marcinmrz/fcase-opatest/README.txt

To jest prototyp "alfa" testera zaczernienia osłonki kolagenowej.
"Alfa" oznacza, że działa albo i nie ;-)
