marcinmrz/fcase-opatest/3D_parts/głowica_vDB9_złożenie.stl

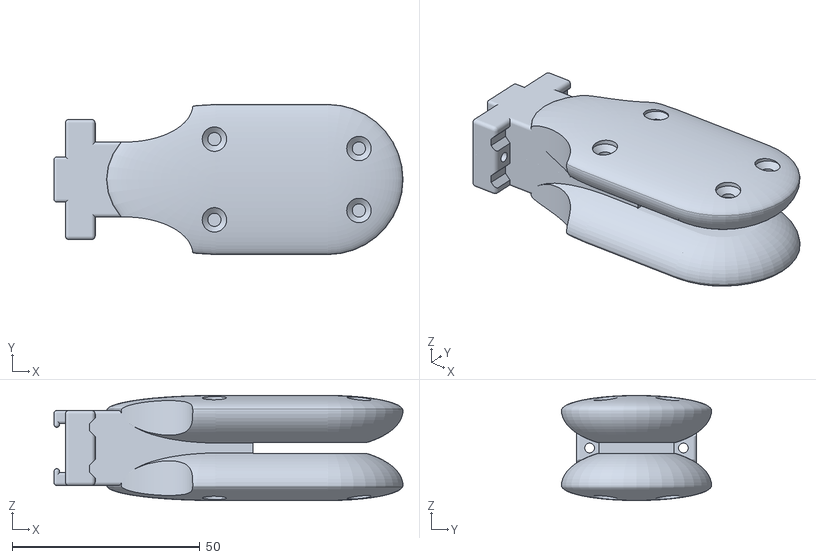
[picture p1: CAD file, 2025-07-26]
3D_parts/głowica_vDB9_złożenie.stl
93.0 x 40.0 x 28.0
