marcinmrz/fcase-opatest/3D_parts/głowica_vDB9_korpus.stl

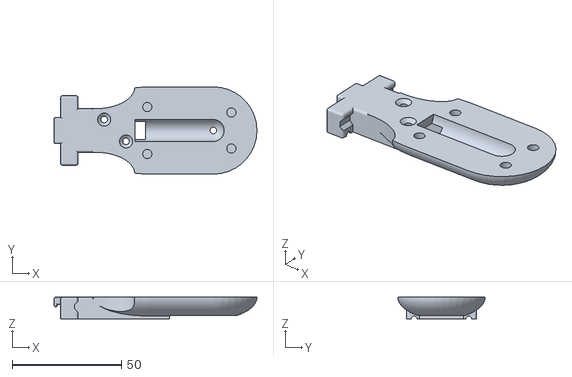
[picture p2: CAD file, 2025-07-26]
3D_parts/głowica_vDB9_korpus.stl
93.0 x 40.0 x 10.0
