marcinmrz/fcase-opatest/3D_parts/głowica_vDB9_dekiel.stl

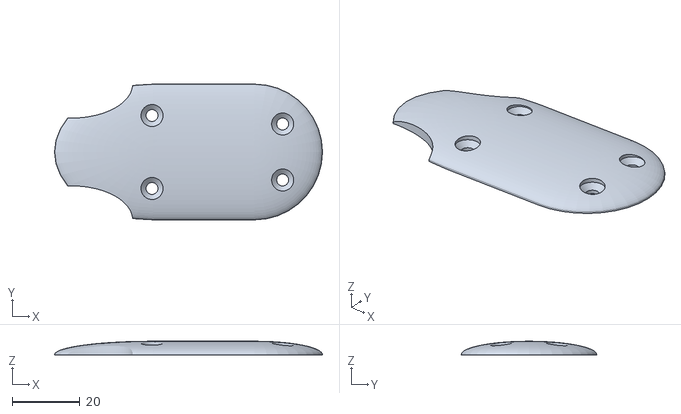
[picture p3: CAD file, 2025-07-26]
3D_parts/głowica_vDB9_dekiel.stl
79.0 x 40.0 x 4.00
