marcinmrz/fcase-opatest/3D_parts/głowica_v1_part2.stl

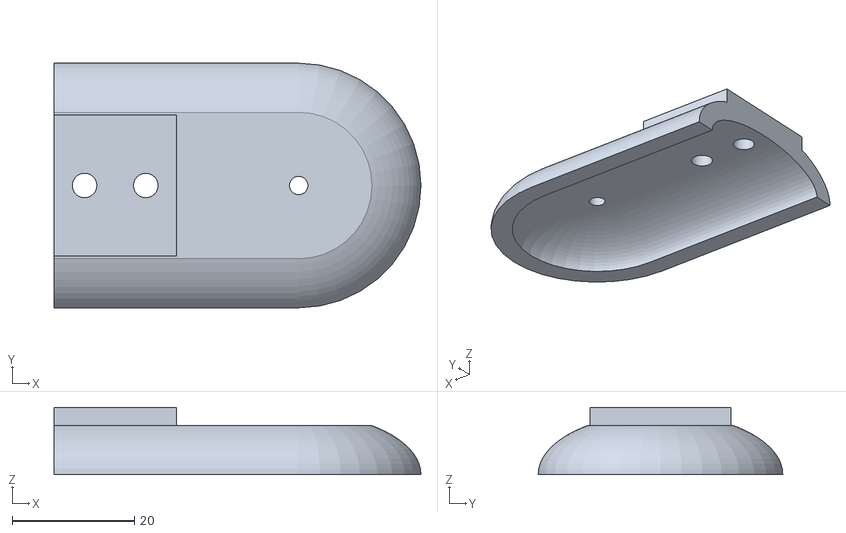
[picture p4: CAD file, 2025-06-30]
3D_parts/głowica_v1_part2.stl
60.0 x 40.0 x 11.0
