marcinmrz/fcase-opatest/3D_parts/głowica_v1_part1.stl

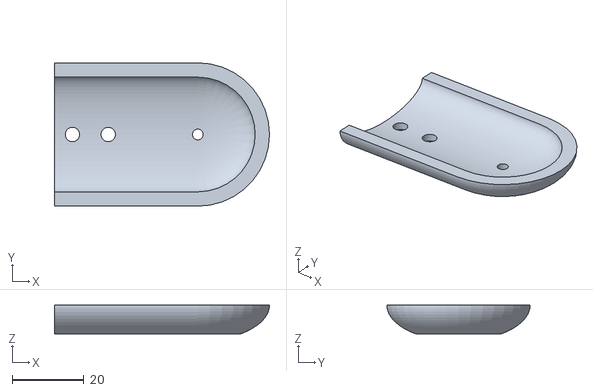
[picture p5: CAD file, 2025-06-30]
3D_parts/głowica_v1_part1.stl
60.0 x 40.0 x 8.00
