marcinmrz/fcase-opatest/3D_parts/głowica_v1_złożenie.stl

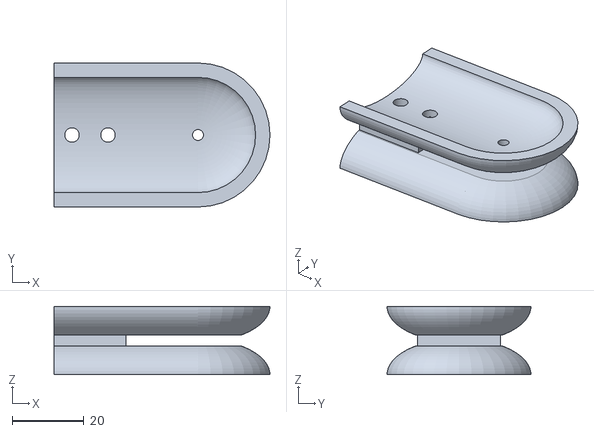
[picture p6: CAD file, 2025-06-30]
3D_parts/głowica_v1_złożenie.stl
60.0 x 40.0 x 19.0
