marcinmrz/fcase-opatest/Schematic_fcace-opatest_2025-06-30.pdf

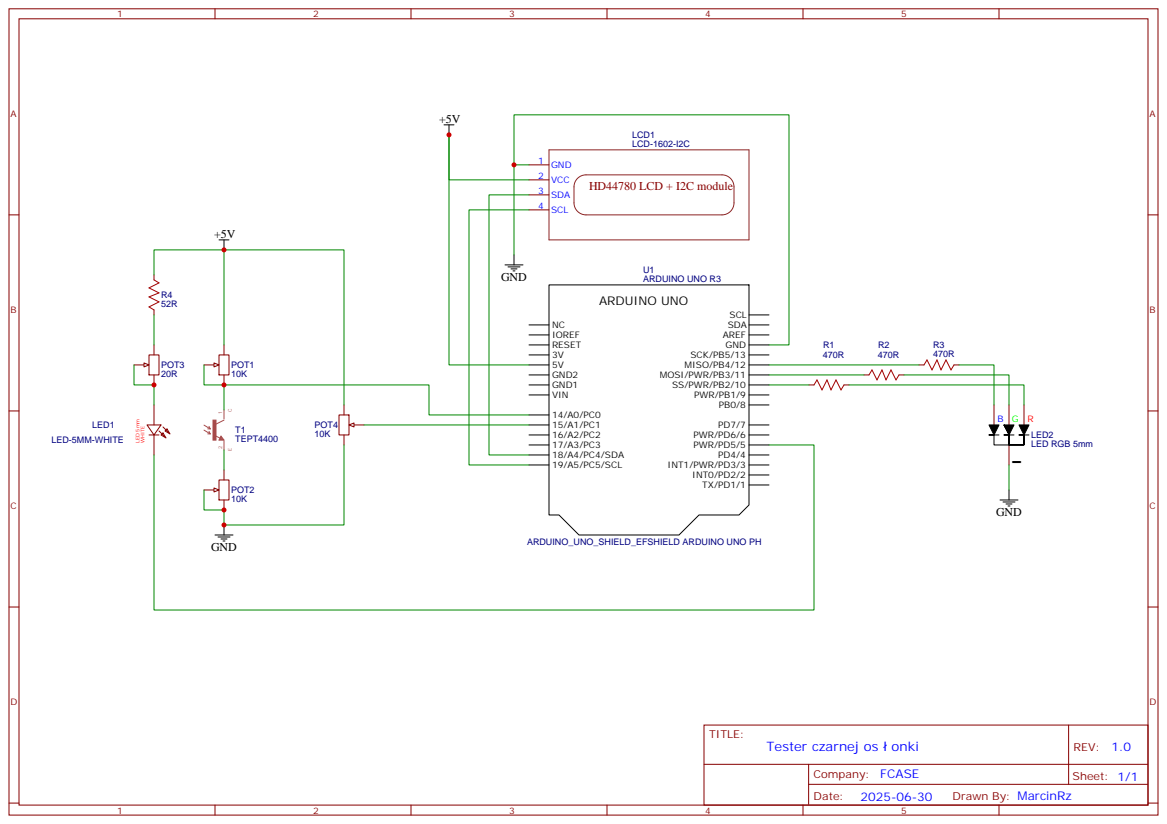
[picture p7: page 1]
