marcinmrz/fcase-opatest/(commit log)

2025-06-29 pierwsza wersja programu na Arduino Uno
2025-06-30 Bryły 3D głowicy na fototranzystor i LED oświetlający
    [głowica_part1.stl, głowica_part2.stl, głowica_złożenie.stl]
2025-07-23 Drobne poprawki po pierwszych testach na fizycznych próbkach
    [opacity-D.xlsx]
2025-07-26 Pliki STL do głowicy ze złączem DB9. Porządki w wersji V1
    [głowica_v1_part1.stl, głowica_v1_part2.stl, głowica_v1_złożenie.stl, głowica_vDB9_dekiel.stl, głowica_vDB9_korpus.stl, głowica_vDB9_złożenie.stl]
